IanSantosRodrigues/Projeto-semb/PRJ2/lista_de_materias.xls

Reference | Value | Datascheet | Codigo Mouser | Footprint | Qty
C1 , C10-C14 | 100nF | ~ | 810-C1608X7R1H104K080AA | Capacitor_SMD:C_0603_1608Metric | 6
C2, C3 | 26pF | ~ | 81-GRM1885C1H270JA01D | Capacitor_SMD:C_0603_1608Metric | 2
C4, C5, C7 | 2.2uF | ~ | 810-C1608X5R1A225K080AC | Capacitor_SMD:C_0603_1608Metric | 3
C6 | 0,01uF | ~ | 81-GRM1885C1H103JA01D | Capacitor_SMD:C_0603_1608Metric | 1
C8 | 10uF | ~ | 810-C1608X5R0J106M080AC | Capacitor_SMD:C_0603_1608Metric | 1
C9 | 4.7uF | ~ | 810-C1608X5R1A475K080AC | Capacitor_SMD:C_0603_1608Metric | 1
C15 | 10nF | ~ | 810-C1608X5R1A105K080AC | Capacitor_SMD:C_0603_1608Metric | 1
C16, C17 | 1uF | ~ | 80-T491X477M010AT | Capacitor_SMD:C_0603_1608Metric | 2
C18, C19 | 470uF | ~ | 810-C1608X7R1H104K080AA | Capacitor_SMD:C_0603_1608Metric | 2
C20, C21 | 0.1uF | ~ | 810-C1608X7R1H104K080AA | Capacitor_SMD:C_0603_1608Metric | 2
D1 | TSSA3U45 | ~ | 78-BZX384C3V3-7-F | Diode_SMD:D_0603_1608Metric_Pad1.05x0.95mm_HandSolder | 1
FB1-FB3 | FerriteBead | ~ | 81-BLM18AG601SN1D | Inductor_SMD:L_0603_1608Metric_Pad1.05x0.95mm_HandSolder | 3
J1 | Load Cell | ~ | 710-TSM-104-01-T-SV | Connector_PinHeader_2.00mm:PinHeader_1x04_P2.00mm_Vertical_SMD_Pin1Left | 1
J2 | DC_MOTOR | ~ | 710-TSM-102-01-T-SV | Connector_PinHeader_2.00mm:PinHeader_1x02_P2.00mm_Vertical_SMD_Pin1Left | 1
J3 | Conn_01x09 | ~ | 710-TSW-109-07-G-S | Connector_PinHeader_2.54mm:PinHeader_1x09_P2.54mm_Vertical | 1
J4 | Conn_01x04 | ~ | 710-TSM-104-01-T-SV | Connector_PinHeader_2.00mm:PinHeader_1x04_P2.00mm_Vertical_SMD_Pin1Left | 1
J5 | Conn_01x02 | ~ | 710-TSM-102-01-T-SV | Connector_PinHeader_2.00mm:PinHeader_1x02_P2.00mm_Vertical_SMD_Pin1Left | 1
JP1, JP2 | SolderJumper_2_Bridged | ~ |  | Jumper:SolderJumper-2_P1.3mm_Bridged_RoundedPad1.0x1.5mm | 2
JP3, JP4 | SolderJumper_2_Open | ~ |  | Jumper:SolderJumper-2_P1.3mm_Open_RoundedPad1.0x1.5mm | 2
L1 | 47uH | ~ | 81-RL1265S-470M | Inductor_SMD:L_6.3x6.3_H3 | 1
R1 | 10K | ~ | 603-RC0603FR-0710KL | Resistor_SMD:R_0603_1608Metric | 1
R2 | 250K | ~ | 603-RC0805FR-07250KL | Resistor_SMD:R_0805_2012Metric_Pad1.20x1.40mm_HandSolder | 1
R3 | 150K | ~ | 603-RC0805FR-07150KL | Resistor_SMD:R_0805_2012Metric_Pad1.20x1.40mm_HandSolder | 1
SW1 | SW_Push | ~ | 688-B3U-1000P-B | Button_Switch_SMD:SW_SPST_B3U-1000P-B | 1
SW2, SW3 | SW_SPDT | ~ | 611-JS102011SAQN | Button_Switch_SMD:SW_SPDT_CK_JS102011SAQN | 2
SW4 | BT4 | ~ | 688-B3U-1000P-B | Button_Switch_SMD:SW_SPST_B3U-1000P-B | 1
SW5 | BT3 | ~ | 688-B3U-1000P-B | Button_Switch_SMD:SW_SPST_B3U-1000P-B | 1
SW6 | BT2 | ~ | 688-B3U-1000P-B | Button_Switch_SMD:SW_SPST_B3U-1000P-B | 1
SW7 | BT1 | ~ | 688-B3U-1000P-B | Button_Switch_SMD:SW_SPST_B3U-1000P-B | 1
U1 | STM32F446RETx | https://www.st.com/resource/en/datasheet/stm32f446re.pdf | 511-STM32F446RET6 | Package_QFP:LQFP-64_10x10mm_P0.5mm | 1
U2 | HX711 | https://web.archive.org/web/20220615044707/https://akizukidenshi.com/download/ds/avia/hx711.pdf | 700-HX711 | Package_SO:SOP-16_3.9x9.9mm_P1.27mm | 1
U3 | LM2596S-3.3 | http://www.ti.com/lit/ds/symlink/lm2596.pdf | 926-LM2596S-3.3/NOPB | Package_TO_SOT_SMD:TO-263-5_TabPin3 | 1
U4 | DRV8833PW | http://www.ti.com/lit/ds/symlink/drv8833.pdf | 595-DRV8833PWPR | Package_SO:TSSOP-16_4.4x5mm_P0.65mm | 1
Y1 | 25MHz | ~ | 517-FA238V25.0000MBPZ | Crystal:Crystal_SMD_SeikoEpson_FA238V-4Pin_3.2x2.5mm | 1
