IanSantosRodrigues/Projeto-semb/PRJ2/PRJ2 (Alimentador Digital)/PRJ2 (Alimentador Digital).kicad_pcb

## KiCad design PRJ2/PRJ2 (Alimentador Digital)/PRJ2 (Alimentador Digital).kicad_pcb (2025-04-23)

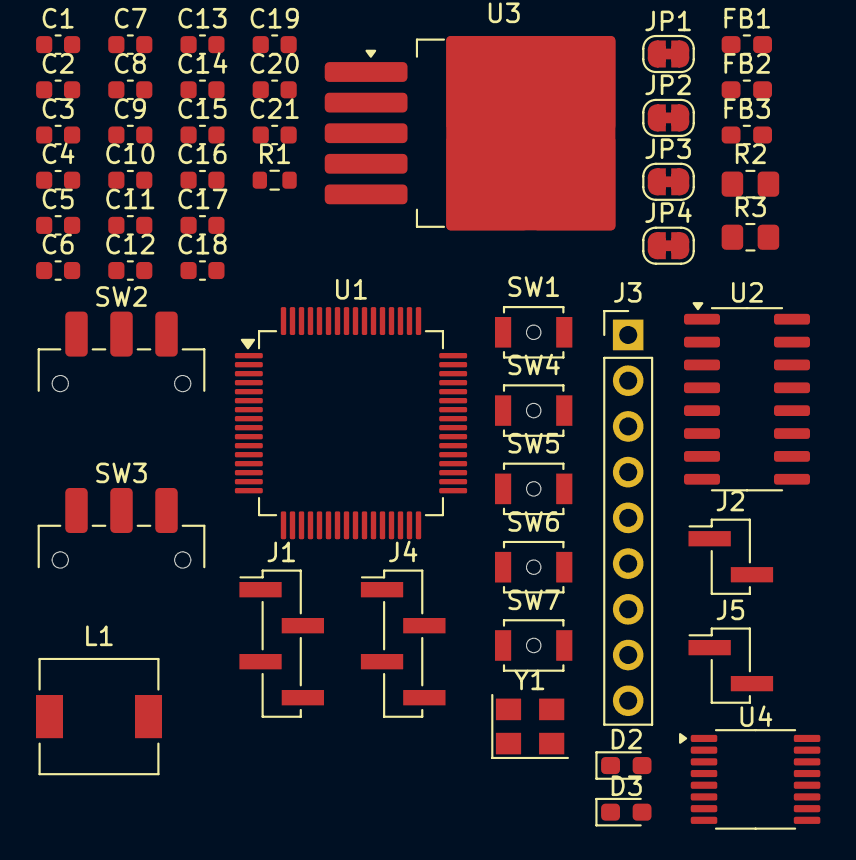
[picture p12: board PRJ2 (Alimentador Digital).kicad_pcb from above]

Board: 2 copper layers, 51 parts (0 on the bottom side), 43 nets, no tracks yet.

Parts:
C1, C10, C11, C12, C13, C14: 100nF; C_0603_1608Metric
C2, C3: 26pF; C_0603_1608Metric
C4, C5, C7: 2.2uF; C_0603_1608Metric
C6: 0,01uF; C_0603_1608Metric
C8: 10uF; C_0603_1608Metric
C9: 4.7uF; C_0603_1608Metric
C15: 10nF; C_0603_1608Metric
C16, C17: 1uF; C_0603_1608Metric
C18, C19: 470uF; C_0603_1608Metric
C20, C21: 0.1uF; C_0603_1608Metric
D2: D_Zener; D_0603_1608Metric_Pad1.05x0.95mm_HandSolder
D3: TSSA3U45; D_0603_1608Metric_Pad1.05x0.95mm_HandSolder
FB1, FB2, FB3: FerriteBead; L_0603_1608Metric_Pad1.05x0.95mm_HandSolder
J1: Load Cell; PinHeader_1x04_P2.00mm_Vertical_SMD_Pin1Left
J2: DC_MOTOR; PinHeader_1x02_P2.00mm_Vertical_SMD_Pin1Left
J3: Conn_01x09; PinHeader_1x09_P2.54mm_Vertical
J4: Conn_01x04; PinHeader_1x04_P2.00mm_Vertical_SMD_Pin1Left
J5: Conn_01x02; PinHeader_1x02_P2.00mm_Vertical_SMD_Pin1Left
JP1, JP2, JP3, JP4: SolderJumper_2_Open; SolderJumper-2_P1.3mm_Bridged_RoundedPad1.0x1.5mm
L1: 47uH; L_6.3x6.3_H3
R1: 10K; R_0603_1608Metric
R2: 250K; R_0805_2012Metric_Pad1.20x1.40mm_HandSolder
R3: 150K; R_0805_2012Metric_Pad1.20x1.40mm_HandSolder
SW1: SW_Push; SW_SPST_B3U-1000P-B
SW2, SW3: SW_SPDT; SW_SPDT_CK_JS102011SAQN
SW4: BT4; SW_SPST_B3U-1000P-B
SW5: BT3; SW_SPST_B3U-1000P-B
SW6: BT2; SW_SPST_B3U-1000P-B
SW7: BT1; SW_SPST_B3U-1000P-B
U1: STM32F446RETx; LQFP-64_10x10mm_P0.5mm
U2: HX711; SOP-16_3.9x9.9mm_P1.27mm
U3: LM2596S-3.3; TO-263-5_TabPin3
U4: DRV8833PW; TSSOP-16_4.4x5mm_P0.65mm
Y1: 25MHz; Crystal_SMD_SeikoEpson_FA238V-4Pin_3.2x2.5mm

Connections:
+3.3V: C4.2, C9.1, C10.1, C11.1, C12.1, C13.1, C14.1, C17.1, FB1.2, FB2.2, FB3.2, J1.4, J4.1, SW2.3 (C), SW4.2, SW5.2, SW6.2, SW7.2, U1.1 (VBAT), U1.19 (VDD), U1.32 (VDD), U1.48 (VDD), U1.64 (VDD), U2.1 (VSUP), U2.3 (AVDD), U2.16 (DVDD)
+9V: C6.1, C7.1, C8.1, C18.1, C20.1, J5.1, U3.1 (VIN), U4.12 (VM), U4.14 (VINT)
/BOOT: R1.2, U1.60 (BOOT0)
/BT1: SW7.1, U1.26 (PB0)
/BT2: SW6.1, U1.27 (PB1)
/BT3: SW5.1, U1.28 (PB2)
/BT4: SW4.1, U1.55 (PB3)
/DC1_IN1: JP1.1 (A), JP3.1 (A), U1.11 (PC3)
/DC1_IN2: JP2.1 (A), JP4.1 (A), U1.24 (PC4)
/DISPL_CS: J3.5, U1.33 (PB12)
/DISPL_DC: J3.7, U1.35 (PB14)
/DISPL_LED: J3.9, U1.38 (PC7)
/DISPL_MOSI: J3.4, U1.23 (PA7)
/DISPL_RST: J3.8, U1.36 (PB15)
/DISPL_SCK: J3.2, U1.21 (PA5)
/FAULT: U1.25 (PC5), U4.8 (~FAULT)
/HSE_IN: C2.1, U1.5 (PH0), Y1.1
/HSE_OUT: C3.1, U1.6 (PH1), Y1.3
/LOAD_DATA: U1.8 (PC0), U2.12 (DOUT)
/LOAD_OUT: U1.9 (PC1), U2.11 (PD_SCK)
/RESET: C1.1, SW1.2, U1.7 (NRST)
/R_OUT: C19.1, C21.1, L1.2, R2.1, SW3.2 (B)
/SWCLK: J4.3, U1.49 (PA14)
/SWDIO: J4.2, U1.46 (PA13)
/TOUCH_CS: J3.6, U1.34 (PB13)
/TOUCH_MOSI: J3.3, U1.22 (PA6)
/TOUNH_INT: J3.1, U1.20 (PA4)
/VDDA: C15.1, C16.1, FB1.1, U1.13 (VDDA)
GND: C1.2, C2.2, C3.2, C4.1, C5.2, C7.2, C8.2, C9.2, C10.2, C11.2, C12.2, C13.2, C14.2, C15.2, C16.2, C17.2, C18.2, C19.2, C20.2, C21.2, D2.2 (A), D3.2 (A), J1.1, J4.4, J5.2, R3.2, SW1.1, SW2.1 (A), U1.12 (VSSA), U1.18 (VSS), U1.31 (VSS), U1.47 (VSS), U1.63 (VSS), U2.5 (AGND), U3.3 (GND), U3.5 (~ON/OFF), U4.3 (AISEN), U4.6 (BISEN), U4.13 (GND), Y1.2, Y1.4
unnamed: D2.1 (K), R1.1, SW2.2 (B)
unnamed: D3.1 (K), L1.1, U3.2 (OUT)
unnamed: J1.2, U2.7 (INA-)
unnamed: J1.3, U2.8 (INA+)
unnamed: J2.1, U4.2 (AOUT1)
unnamed: J2.2, U4.4 (AOUT2)
unnamed: JP1.2 (B), U4.16 (AIN1)
unnamed: JP2.2 (B), U4.15 (AIN2)
unnamed: JP3.2 (B), U4.9 (BIN1)
unnamed: JP4.2 (B), U4.10 (BIN2)
unnamed: FB2.1, FB3.1, SW3.1 (A)
unnamed: C5.1, U2.6 (VBG)
unnamed: R2.2, R3.1, U3.4 (FB)
unnamed: C6.2, U4.11 (VCP)
