IanSantosRodrigues/Projeto-semb/PRJ3_Alimentador_Digital/PRJ3_Alimentador_Digital/Core/Inc/main.h

#define HSE_IN_Pin GPIO_PIN_0
#define HSE_IN_GPIO_Port GPIOH
#define HSE_OUT_Pin GPIO_PIN_1
#define HSE_OUT_GPIO_Port GPIOH
#define LOAD_DATA_Pin GPIO_PIN_0
#define LOAD_DATA_GPIO_Port GPIOC
#define LOAD_CLK_Pin GPIO_PIN_1
#define LOAD_CLK_GPIO_Port GPIOC
#define RESET_DSP_Pin GPIO_PIN_4
#define RESET_DSP_GPIO_Port GPIOA
#define DC_DSP_Pin GPIO_PIN_5
#define DC_DSP_GPIO_Port GPIOA
#define BLK_DSP_Pin GPIO_PIN_6
#define BLK_DSP_GPIO_Port GPIOA
#define FAULT_Pin GPIO_PIN_5
#define FAULT_GPIO_Port GPIOC
#define DC1_IN2_Pin GPIO_PIN_12
#define DC1_IN2_GPIO_Port GPIOB
#define DC1_IN1_Pin GPIO_PIN_12
#define DC1_IN1_GPIO_Port GPIOA
#define SWDIO_Pin GPIO_PIN_13
#define SWDIO_GPIO_Port GPIOA
#define SWCLK_Pin GPIO_PIN_14
#define SWCLK_GPIO_Port GPIOA
#define SCL_DSP_Pin GPIO_PIN_3
#define SCL_DSP_GPIO_Port GPIOB
#define SDA_DSP_Pin GPIO_PIN_5
#define SDA_DSP_GPIO_Port GPIOB
