IanSantosRodrigues/Projeto-semb/(commit log)

2025-04-24 att da pcb
2025-04-24 att da pcb v2
    [PRJ4 (Alimentador Digital).kicad_pcb, PRJ4 (Alimentador Digital).kicad_sch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]
2025-04-24 criado pasta Inc e Src dentro do código de autoria
2025-04-30 nomes do pinos
    [PRJ4 (Alimentador Digital).kicad_pcb, PRJ4 (Alimentador Digital).kicad_sch]
2025-04-30 mudei os pinos
    [PRJ4 (Alimentador Digital).kicad_pcb]
2025-05-02 alguma alteração que não sei
2025-05-02 Utima alteração para entregar o projeto
    [PRJ4 (Alimentador Digital)-B_Cu.gbl, PRJ4 (Alimentador Digital)-B_Mask.gbs, PRJ4 (Alimentador Digital)-B_Paste.gbp, PRJ4 (Alimentador Digital)-B_Silkscreen.gbo, PRJ4 (Alimentador Digital)-Edge_Cuts.gm1, PRJ4 (Alimentador Digital)-F_Cu.gtl, PRJ4 (Alimentador Digital)-F_Mask.gts, PRJ4 (Alimentador Digital)-F_Paste.gtp]
